claudioolmedo/onedollarboard.com/download/OneDollarBoard.com.1.004.r1.png

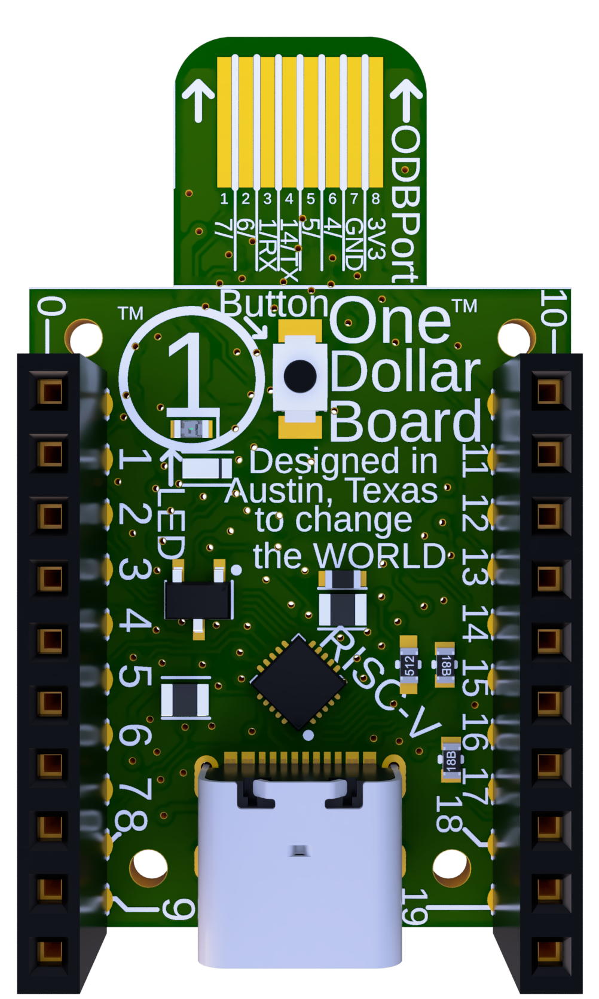
download/OneDollarBoard.com.1.004.r1.png
