claudioolmedo/onedollarboard.com/download/OneDollarBoard_V1.004_R1_LCSC_BOM.xlsx

Quantity | LCSC Part Number | Description | Designator | Package
2 | C350306 | Pin Header 1x10 2.54mm | JP1, JP2 | 1X10
1 | C22843 | 1.5kΩ ±1% | R_USB_PU | RES5.1K_0603
1 | C720477 | Tactile 4x3mm | S1 | B3U-1000P(M)
1 | C5446 | 3.3V LDO | U$1 | XC6206P332MR-G
1 | C2765186 | USB-C 16Pin | U$2 | CONN_TYPE-C-16P
1 | C21190 | 1kΩ ±1% | U$3 | RESC2208X45
1 | C965803 | Yellow 0603 | U$4 | LEDC1507X40
1 | C15849 | 1uF 50V X5R | U$5 | WE-VS_0603
1 | C15850 | 10uF 25V X5R | U$6 | CAP0603
1 | C5299908 | CH32V003F4U6 | U$7 | CH32V003F4U6
2 | C23186 | 5.1kΩ ±1% | U$8, U$9 | RES1.5K_0603
