claudioolmedo/onedollarboard.com/download/OneDollarBoard.com.1.004.stl

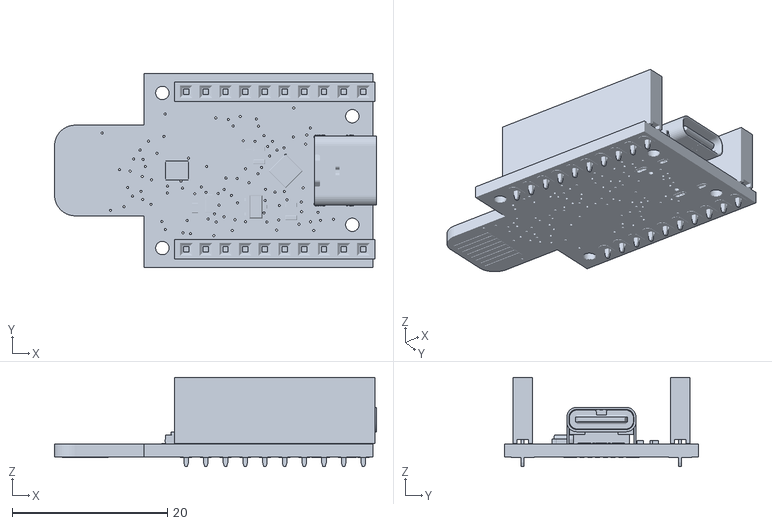
[picture p2: CAD file, 2026-03-18]
download/OneDollarBoard.com.1.004.stl
41.5 x 25.0 x 11.5
