claudioolmedo/onedollarboard.com/download/OneDollarBoard.com.1.004.r1.3mf

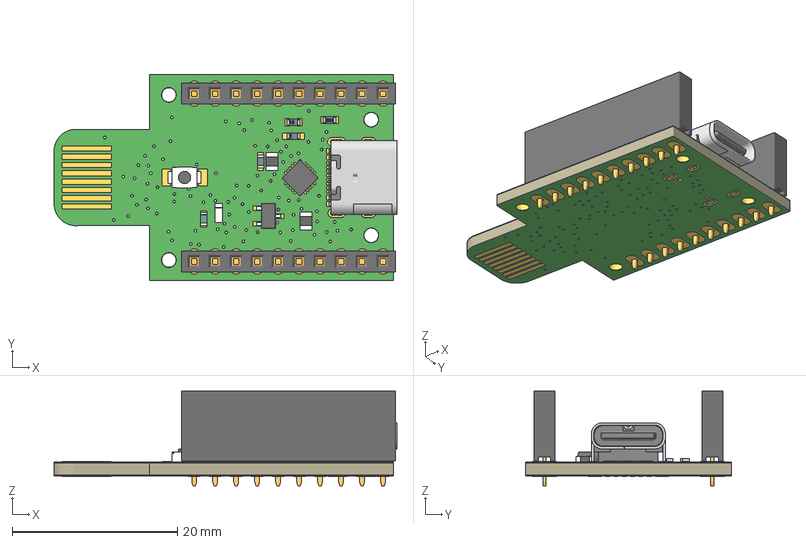
[picture p3: CAD file, 2026-02-11]
download/OneDollarBoard.com.1.004.r1.3mf
41.5 x 25.0 x 11.5 mm
Board
CopperHoles
