claudioolmedo/onedollarboard.com/docs/OneDollarBoard.com.v1.004.r1.pinout.pdf

# ODB Port

+

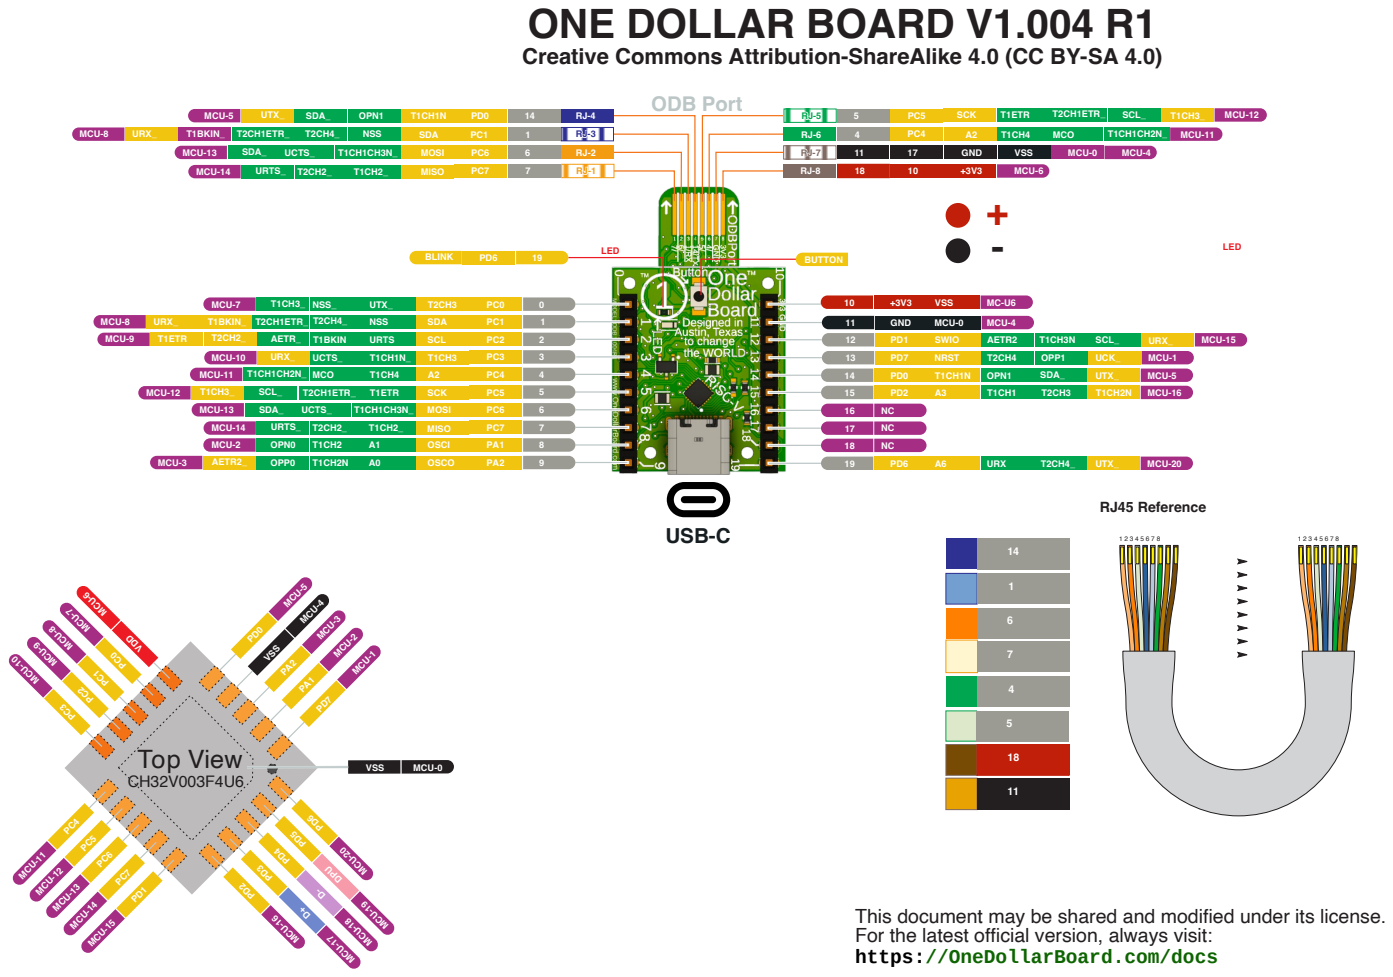
[picture p4: page 1]
RJ45 Reference; MCU 1- 6; MCU 2- 0; MCU-15; MCU-14; MCU-13; MCU-12; MCU-11; MCU 1- 0; MCU 9-; MCU 8-; MCU 7-; VDD; MCU 6-; MCU-5; VSS; MCU-4; MCU-3; MCU-2; MCU-1; Top View; MCU 1- 8; MCU 1- 9; DPU; MCU 1- 7; MCU-0; USB-C; BLINK; LED; SCL; SCK; MOSI; OSCO; SDA; UTX_; URTS; T1ETR; NSS; NSS_; T1BKIN; UCTS_; MCO; T2CH1ETR_; AETR_; SCL_; SDA_; OPP0; URX_; AETR2_; MCU-7; T1BKIN_; MCU-10; MCU-8; MCU-9; GND; NRST; SWIO; OPN1; AETR2; URX; OPP1; UCK_; MCU-16; MCU-20; URTS_; MISO; MCU-6; BUTTON

ONE DOLLAR BOARD V1.004 R1
Creative Commons Attribution-ShareAlike 4.0 (CC BY-SA 4.0)

URTS_ | T2CH2_ | T1CH2_ | MISO | PC7
OPN0 | T1CH2 | A1 | OSCI | PA1

This document may be shared and modified under its license.
For the latest official version, always visit:
https://OneDollarBoard.com/docs
