claudioolmedo/onedollarboard.com/download/OneDollarBoard.com.1.004.r1.brd

## EAGLE design download/OneDollarBoard.com.1.004.r1.brd (2026-02-11)

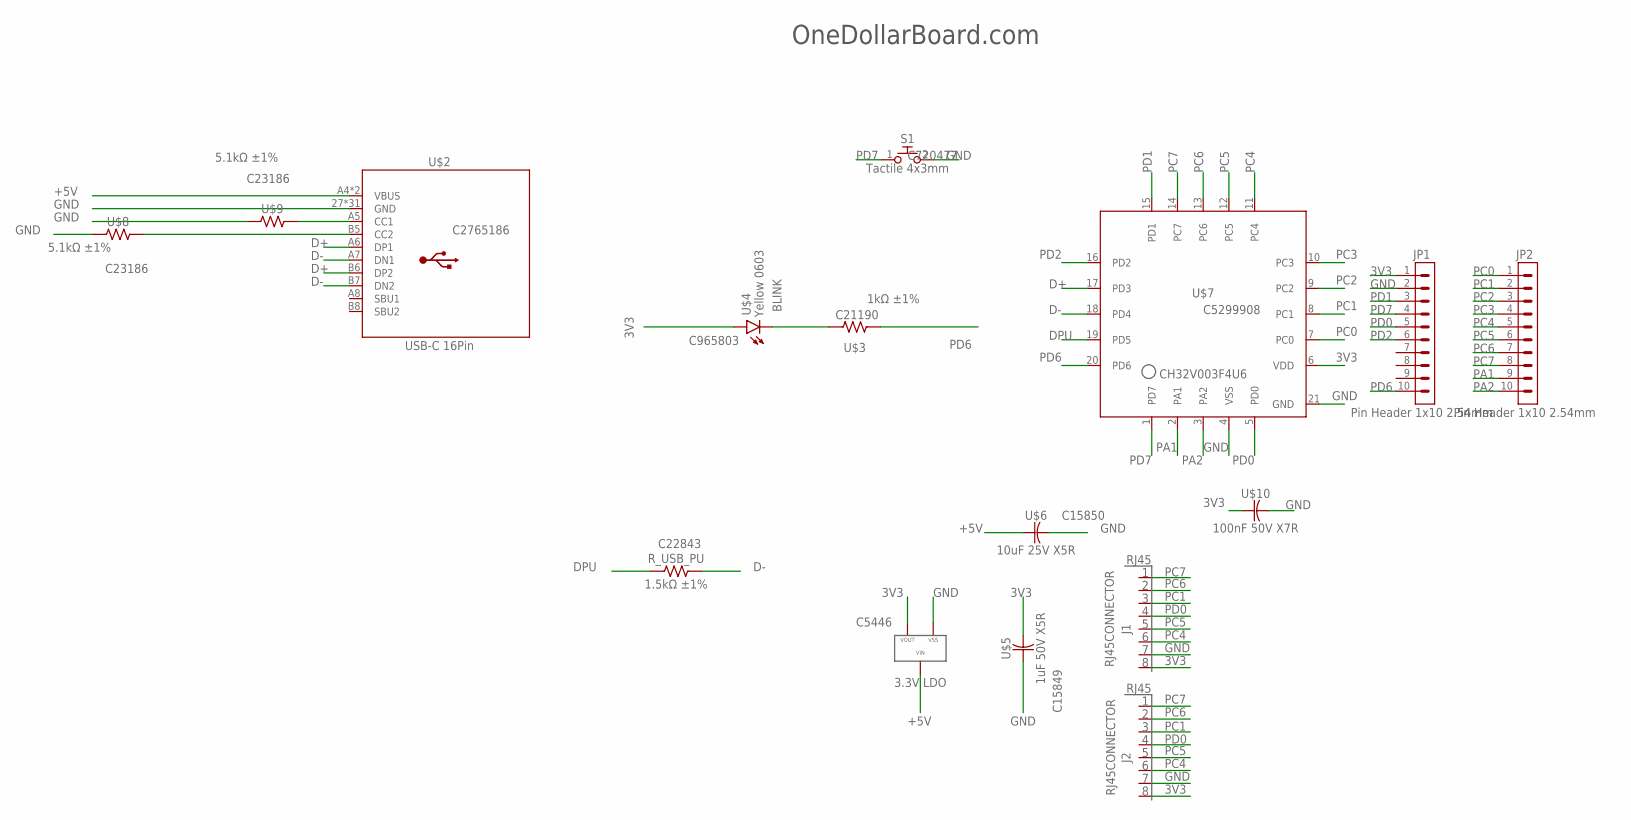
[picture p5: schematic OneDollarBoard.com.1.004.r1.sch]

Parts:
J1, J2: RJ45CONNECTOR; 2.54/1.0
JP1, JP2: Pin Header 1x10 2.54mm; 1X10; LCSC C350306
R_USB_PU: 1.5kΩ ±1%; WRIS-RSKS_0603_WAVE; LCSC C22843
S1: Tactile 4x3mm; B3U-1000P(M); LCSC C720477
U$1: 3.3V LDO; XC6206P332MR-G; LCSC C5446
U$2: USB-C 16Pin; CONN_TYPE-C-16P; LCSC C2765186
U$3: 1kΩ ±1%; RESC2208X45; LCSC C21190
U$4: Yellow 0603; LEDC1507X40; LCSC C965803
U$5: 1uF 50V X5R; CPA1UF; LCSC C15849
U$6: 10uF 25V X5R; CAP0603; LCSC C15850
U$7: CH32V003F4U6; LCSC C5299908
U$8, U$9: 5.1kΩ ±1%; WRIS-RSKS_0603_REFLOW; LCSC C23186
U$10: 100nF 50V X7R; CAP0603

Connections:
3V3: J1.P$1 (P1), J2.P$1 (P1), JP1.1, U$1.2, U$4.A, U$5.2, U$7.6 (VDD), U$10.1
+5V: U$1.3, U$2.A4 (VBUS), U$2.B4 (VBUS), U$6.1
BLINK: U$3.1, U$4.C
D+: U$2.A6 (DP1), U$2.B6 (DP2), U$7.17 (PD3)
D-: R_USB_PU.2, U$2.A7 (DN1), U$2.B7 (DN2), U$7.18 (PD4)
DPU: R_USB_PU.1, U$7.19 (PD5)
GND: J1.P$2 (P2), J2.P$2 (P2), JP1.2, S1.2, U$1.1, U$2.27 (GND), U$2.28 (GND), U$2.29 (GND), U$2.30 (GND), U$2.A1 (GND), U$2.B1 (GND), U$2.S_1 (GND), U$2.S_1_H1 (GND), U$2.S_1_H2 (GND), U$2.S_2 (GND), U$2.S_2_H1 (GND), U$2.S_2_H2 (GND), U$2.S_2_H3 (GND), U$2.S_2_H4 (GND), U$2.S_2_H5 (GND), U$2.S_2_H6 (GND), U$2.S_2_H7 (GND), U$2.S_2_H12 (GND), U$2.S_2_H13 (GND), U$2.S_3 (GND), U$2.S_3_H1 (GND), U$2.S_3_H2 (GND), U$2.S_3_H3 (GND), U$2.S_3_H4 (GND), U$2.S_3_H5 (GND), U$2.S_4 (GND), U$2.S_4_H1 (GND), U$2.S_4_H2 (GND), U$2.S_4_H3 (GND), U$2.S_4_H4 (GND), U$2.S_4_H5 (GND), U$5.1, U$6.2, U$7.4 (VSS), U$7.21 (GND), U$8.1, U$9.1, U$10.2
unnamed: U$2.A5 (CC1), U$9.2
unnamed: U$2.B5 (CC2), U$8.2
PA1: JP2.9, U$7.2 (PA1)
PA2: JP2.10, U$7.3 (PA2)
PC0: JP2.1, U$7.7 (PC0)
PC1: J1.P$6 (P6), J2.P$6 (P6), JP2.2, U$7.8 (PC1)
PC2: JP2.3, U$7.9 (PC2)
PC3: JP2.4, U$7.10 (PC3)
PC4: J1.P$3 (P3), J2.P$3 (P3), JP2.5, U$7.11 (PC4)
PC5: J1.P$4 (P4), J2.P$4 (P4), JP2.6, U$7.12 (PC5)
PC6: J1.P$7 (P7), J2.P$7 (P7), JP2.7, U$7.13 (PC6)
PC7: J1.P$8 (P8), J2.P$8 (P8), JP2.8, U$7.14 (PC7)
PD0: J1.P$5 (P5), J2.P$5 (P5), JP1.5, U$7.5 (PD0)
PD1: JP1.3, U$7.15 (PD1)
PD2: JP1.6, U$7.16 (PD2)
PD6: JP1.10, U$3.2, U$7.20 (PD6)
PD7: JP1.4, S1.1, U$7.1 (PD7)

Notes on the sheet:
OneDollarBoard.com

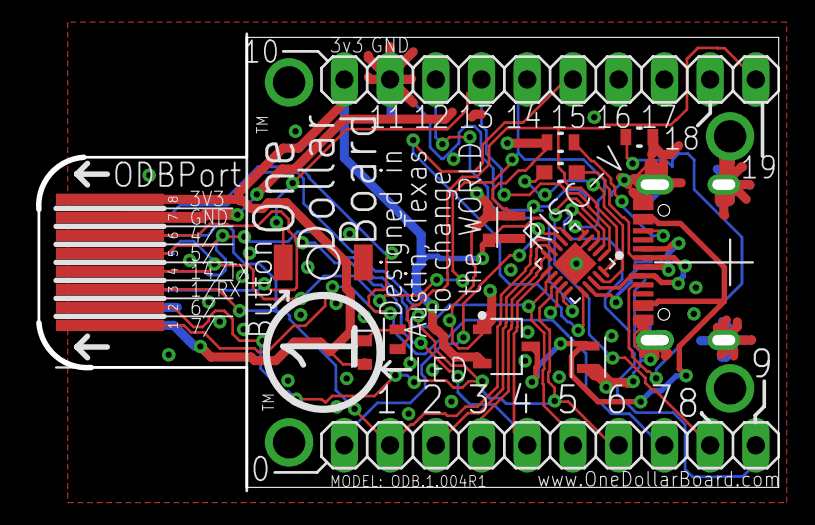
[picture p6: board OneDollarBoard.com.1.004.r1.brd from above]

Board: 2 copper layers, 41.1 x 25.0 mm, 16 parts (1 on the bottom side), 24 nets.
