claudioolmedo/onedollarboard.com/(commit log)

2026-02-11 Release 1.004 R1
    [OneDollarBoard.com.1.004.r1.3mf, OneDollarBoard.com.1.004.r1.brd, OneDollarBoard.com.1.004.r1.sch]
2026-02-11 BOM & Library
    [OneDollarBoard.com.BOM.1.004.r1.csv]
2026-02-11 jlcpcb pcb gerber file
2026-02-11 add bom for lcsc
    [OneDollarBoard_V1.004_R1_LCSC_BOM.xlsx]
2026-02-11 fixed J1 and J2 PCB part
2026-03-13 Add One Dollar Board pinout YAML
    Add docs/onedollarboard.1.004.r1.pinout.yaml containing pinout documentation for One Dollar Board v1.004 R1. The YAML lists the MCU (CH32V003F4U6), connector (ODB/RJ45) and per-pin mappings (signals, MCU pins, RJ pins and available functions) for pins 1–12 and 20, including 3.3V and GND. Provides a hardware reference for wiring and software pin assignments.
2026-03-18 Add OneDollarBoard.com v1.004 STL
    Add the binary STL 3D model (download/OneDollarBoard.com.1.004.stl) for OneDollarBoard.com version 1.004 to the repository's download folder to provide a printable model(mecanical) for users.
    [OneDollarBoard.com.1.004.stl]
